ErlendLS/TFE4850/hardware/altium/schematic/a3bu.PNG

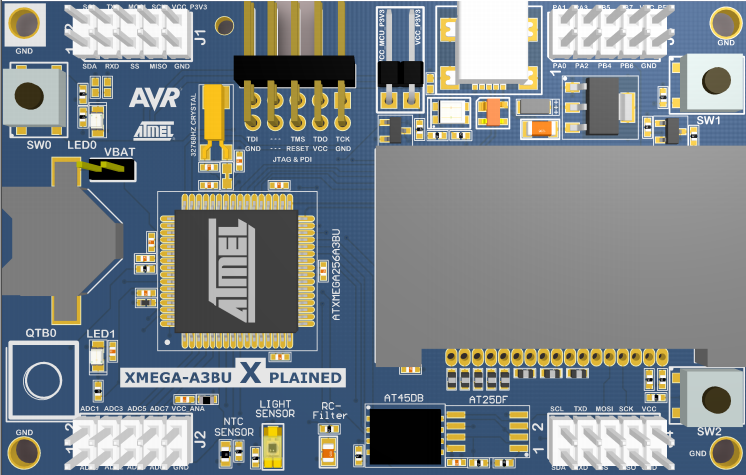
hardware/altium/schematic/a3bu.PNG
