ErlendLS/TFE4850/README.md

TFE4850
=======

Eksperter i Team, Romteknologi, Prosjektrepo
