ErlendLS/TFE4850/hardware/MCU pinout.xlsx

MCU pin | MCU pin mode | Header pin | Xplained pin name | Use on Sensorboard | Use on Xplained
PC0 | TWIC-SDA | J1-1 | SDA | SDA | -
PC1 | TWIC-SCL | J1-2 | SCL | SCL | -
PC2 | GPIO | J1-3 | RXD | OUTPUT_CONTROL1 | -
PC3 | GPIO | J1-4 | TXD | OUTPUT_CONTROL2 | -
PC4 | GPIO | J1-5 | SS | OUTPUT_CONTROL3 | -
PC5 | GPIO | J1-6 | MOSI | OUTPUT_CONTROL4 | -
PC6 |  | J1-7 | MISO | NC | -
PC7 |  | J1-8 | SCK | NC | -
- | - | J1-9 | GND | GND | -
- | - | J1-10 | VCC_P3V3 | NC | -
PB0 | REFB-AREF | J2-1 | ADC0 | VREF_ADC | -
PB1 | ADCB POS-ADC1 | J2-2 | ADC1 | TEMP1 | -
PB2 | ADCB POS-ADC2 | J2-3 | ADC2 | TEMP2 | -
PB3 | ADCB POS-ADC3 | J2-4 | ADC3 | TEMP3 | -
PA4 | ADCB POS-ADC12 | J2-5 | ADC4 | TEMP4 | -
PA5 | ADCB POS-ADC13 | J2-6 | ADC5 | BOARD_GND | -
PA6 |  | J2-7 | ADC6 | NC | -
PA7 |  | J2-8 | ADC7 | NC | -
- | - | J2-9 | GND | GND | -
- | - | J2-10 | VCC_P3V3 | NC | -
PA0 |  | J3-1 | PA0 | NC | Light sensor | cut possible
PA1 |  | J3-2 | PA1 | NC | Temperature sensor | cut possible
PA2 |  | J3-3 | PA2 | NC | Filter output | cut possible
PA3 |  | J3-4 | PA3 | NC | Display reset
PB4 |  | J3-5 | PB4 | NC | JTAG TMS
PB5 |  | J3-6 | PB5 | NC | JTAG TDI
PB6 |  | J3-7 | PB6 | NC | JTAG TCK
PB7 |  | J3-8 | PB7 | NC | JTAG TDO
- | - | J3-9 | GND | GND | -
- | - | J3-10 | VCC_P5V0 | 5V_XPLAINED | -
PE0 |  | J4-1 | SDA | NC | -
PE1 |  | J4-2 | SCL | NC | -
PE2 |  | J4-3 | RXD | NC | -
PE3 |  | J4-4 | TXD | NC | -
PD0 |  | J4-5 | SS | NC | Display register select
PD3 |  | J4-6 | MOSI | NC | Serial flash MOSI
PD2 |  | J4-7 | MISO | NC | Display and flash
PD1 |  | J4-8 | SCK | NC | Display and flash
- | - | J4-9 | GND | NC | -
- | - | J4-10 | VCC_P3V3 | NC | -
