ErlendLS/TFE4850/hardware/altium/Project Outputs for sensorboard/bom_test.xls

Sheet: BOM Report
Bill of Materials |  |  | Bill of Materials For Project [sensorboard.PrjPCB] (No PCB Document Selected)
Source Data From: |  | sensorboard.PrjPCB
Project: |  | sensorboard.PrjPCB
Variant: |  | None
Creation Date: | 21.02.2014 | 00:30:20
Print Date: | 2014-02-21 | 0:30:28
Production Quantity: | 1
Currency | <none>
Footprint | Comment | #Column Name Error:LibRef | Designator | Description | Quantity | Supplier 1 | Supplier Part Number 1 | Supplier Unit Price 1 | Supplier Order Qty 1 | Supplier Subtotal 1 | #Column Name Error:Manufacturer 1 | #Column Name Error:Manufacturer Part Number 1
 | CRCW0805715KFKEA |  | R14_T1, R14_T2, R14_T3, R14_T4 | Thick film resistor, 1%, 125mW | 4 | Mouser | 71-CRCW0805715KFKEA | 0,541 | 4 | $2164.00
 | CRCW0805442RFKEA |  | R7_T1, R7_T2, R7_T3, R7_T4 | Thick film resistor, 1%, 125mW | 4 | Mouser | 71-CRCW0805-442-E3 | 0,541 | 4 | $2164.00
 | CRCW0805300RFKEA |  | R15, R17, R19, R21 | Thick film resistor, 1%, 125mW | 4 | Mouser | 71-CRCW0805300RFKEA | 0,541 | 4 | $2164.00
 | CRCW0805294KFKEA |  | R13_T1, R13_T2, R13_T3, R13_T4 | Thick film resistor, 1%, 125mW | 4 | Mouser | 71-CRCW0805294KFKEA | 0,541 | 4 | $2164.00
 | CRCW0805220RFKEA |  | R27 | Thick film resistor, 1%, 125mW | 1 | Mouser | 71-CRCW0805-220-E3 | 0,541 | 1 | 0,541
 | CRCW0805215KFKEA |  | R12_T1, R12_T2, R12_T3, R12_T4 | Thick film resistor, 1%, 125mW | 4 | Mouser | 71-CRCW0805-215K-E3 | 0,541 | 4 | $2164.00
 | CRCW0805133KFKEA |  | R11_T1, R11_T2, R11_T3, R11_T4 | Thick film resistor, 1%, 125mW | 4 | Mouser | 71-CRCW0805-133K-E3 | 0,541 | 4 | $2164.00
 | C0805C104K5RACTU |  | C1, C2, C3_T1, C3_T2, C3_T3, C3_T4, C4_T1, C4_T2, C4_T3, C4_T4, C15, C16, C19 | Ceramic capacitor, X7R, 10%, 50V | 13 | Mouser | 80-C0805C104K5R | 0,676 | 13 | $8788.00
 | C3216C0G1H104J160AA |  | C23 | Ceramic capacitor, C0G, 5%, 50V | 1 | Mouser | 810-C3216C0G1H104J | 4,66 | 1 | 4,66
 | GRM31C5C1E104JA01L |  | C8_T1, C8_T2, C8_T3, C8_T4, C9_T1, C9_T2, C9_T3, C9_T4 | Ceramic capacitor, C0G, 5%, 25V | 8 | Mouser | 81-GRM31C5C1E104JA01 | 2,15 | 10 | 21,5
 | ERJ-6RSFR10V |  | R26 | Thick film resistor, 1%, 125mW | 1 | Mouser | 667-ERJ-6RSFR10V | 4,19 | 1 | 4,19
 | GRM31C5C1H823GA01L |  | C10_T1, C10_T2, C10_T3, C10_T4 | Ceramic capacitor, C0G, 2%, 50V | 4 | Mouser | 81-GRM31C5C1H823GA1L | 7,71 | 4 | 30,84
 | RG2012P-4022-B-T5 |  | R23 | Thin film resistor, 0.1%, 100mW | 1 | Mouser | 754-RG2012P-4022-BT5 | 1,96 | 1 | 1,96
 | CRCW080522K6FKEA |  | R9_T1, R9_T2, R9_T3, R9_T4 | Thick film resistor, 1%, 125mW | 4 | Mouser | 71-CRCW0805-22.6K-E3 | 0,541 | 4 | $2164.00
 | GRM21B5C1H223JA01L |  | C6_T1, C6_T2, C6_T3, C6_T4 | Ceramic capacitor, C0G, 5%, 50V | 4 | Mouser | 81-GRM215C1H223JA01L | 2,16 | 4 | 8,64
 | CRCW080520R0FKEA |  | R28 | Thick film resistor, 1%, 125mW | 1 | Mouser | 71-CRCW0805-20-E3 | 0,541 | 1 | 0,541
 | GRM2195C1H123JA01D |  | C11_T1, C11_T2, C11_T3, C11_T4 | Ceramic capacitor, C0G, 5%, 50V | 4 | Mouser | 81-GRM2195C1H123JA1D | 2,84 | 4 | 11,36
 | C3216X7R1C106K160AC |  | C12, C13 | Ceramic capacitor, X7R, 10%, 16V | 2 | Mouser | 810-C3216X7R1C106K | 2,30 | 2 | 4,6
 | CRCW080510M0FKEA |  | R5_T1, R5_T2, R5_T3, R5_T4 | Thick film resistor, 1%, 125mW | 4 | Mouser | 71-CRCW0805-10M-E3 | 0,541 | 4 | $2164.00
 | CRCW080510K0FKEB |  | R3, R4, R6_T1, R6_T2, R6_T3, R6_T4, R8_T1, R8_T2, R8_T3, R8_T4, R10_T1, R10_T2, R10_T3, R10_T4, R16, R18, R20, R22 | Thick film resistor, 1%, 125mW | 18 | Mouser | 71-CRCW080510K0FKEB | 0,321 | 18 | $5778.00
 | RG2012P-103-B-T5 |  | R24 | Thin film resistor, 0.1%, 100mW | 1 | Mouser | 754-RG2012P-103-B-T5 | 1,96 | 1 | 1,96
 | C2012X7R1A475K125AC |  | C22 | Ceramic capacitor, X7R, 10%, 10V | 1 | Mouser | 810-C2012X7R1A475K | 1,76 | 1 | 1,76
 | CRCW08054K70FKEB |  | R1, R2 | Thick film resistor, 1%, 125mW | 2 | Mouser | 71-CRCW08054K70FKEB | 0,541 | 2 | $1082.00
 | C0805C105K4RACTU |  | C14, C17, C18, C20, C21_T1, C21_T2, C21_T3, C21_T4 | Ceramic capacitor, X7R, 10%, 16V | 8 | Mouser | 80-C0805C105K4R | 0,811 | 8 | $6488.00
 | GRM2165C1H102JA01D |  | C5_T1, C5_T2, C5_T3, C5_T4, C7_T1, C7_T2, C7_T3, C7_T4 | Ceramic capacitor, C0G, 5%, 50V | 8 | Mouser | 81-GRM40C102J50D | 0,389 | 10 | 3,89
 | CRCW08050000Z0EA |  | R25_T1, R25_T2, R25_T3, R25_T4 | Thick film resistor, 1%, 125mW | 4 | Mouser | 71-CRCW0805-0-E3 | 0,541 | 4 | $2164.00
 | 1751248 |  | J4, J5, J6, J7, J9 | Terminal block, 2P, 3.5mm, screw | 5 | Mouser | 651-1751248 | 7,50 | 5 | 37,5
 | 1751303 |  | J8 | Terminal block, 8P, 3.5mm, screw | 1 | Mouser | 651-1751303 | 28,90 | 1 | 28,9
 | AD623BRZ |  | U4_T1, U4_T2, U4_T3, U4_T4 | Instrumentation amplifier, rail to rail | 4 | Mouser | 584-AD623BRZ | 42,33 | 4 | 169,32
 | ADR3425ARJZ |  | U13 | Series voltage reference, 2.5V | 1 | Mouser | 584-ADR3425ARJZ-R7 | 17,49 | 1 | 17,49
 | ADT7410TRZ |  | U2 | Temperature sensor, I2C output | 1 | Mouser | 584-ADT7410TRZ | 23,83 | 1 | 23,83
 | AQV252GA |  | U5, U6, U7, U8 | Solid state relay, DC/AC, 60V, 2.5A | 4 | Mouser | 769-AQV252GA | 34,98 | 4 | 139,92
 | HSCDANN015PA2A3 |  | U1 | Absolute pressure sensor, I2C output | 1 | Mouser | 785-HSCDANN015PA2A3 | 298,37 | 1 | 298,37
 | KP-3216CGCK |  | D1 | Chip led lamp,green, 50mcd @ 20mA | 1 | Farnell | 2290333 | 0,94 | 1
 | LMP7702MA/NOPB |  | U3_T1, U3_T2, U3_T3, U3_T4, U10 | Op. amp, dual, rail-to-rail, single supply | 5 | Farnell | 1651867 | 18,17 | 5
 | SA36CA-E3/54 |  | TVS1, TVS2, TVS3, TVS4 | TVS diode, bidirectional, 36 V | 4 | Mouser | 625-SA36CA-E3/54 | 3,45 | 4 | 13,8
 | T821110A1S100CEU |  | J1, J2, J3 | Header, 2x5, 2.54mm | 3 | Farnell | 2215304 | 4,03 | 3
 | Test_point |  | TP1, TP2, TP3_T1, TP3_T2, TP3_T3, TP3_T4, TP4_T1, TP4_T2, TP4_T3, TP4_T4, TP5, TP6, TP7, TP8, TP9 | Test_point | 15
 | TPS7A4533DCQ |  | U9 | LDO regulator, 3.3V, 1.5A | 1 | Mouser | 595-TPS7A4533DCQT | 25,35 | 1 | 25,35
 |  |  |  |  | 160 |  |  |  |  | $41612.00
Approved |  | Notes

Sheet: Project Information
Project Full Path | C:\Users\Harald\Documents\Dropbox\Studier\Semester 08\TFE4850 - EIT romteknologi\TFE4850\hardware\altium\sensorboard.PrjPCB
Project Filename | sensorboard.PrjPCB
Variant Name | None
Data-Source Filename | sensorboard.PrjPCB
Data-Source Full Path | C:\Users\Harald\Documents\Dropbox\Studier\Semester 08\TFE4850 - EIT romteknologi\TFE4850\hardware\altium\sensorboard.PrjPCB
Title | Bill of Materials For Project [sensorboard.PrjPCB] (No PCB Document Selected)
Total Quantity | 160
Report Time | 00:30:20
Report Date | 21.02.2014
Report Date & Tine | 21.02.2014 00:30:20
Output Name | Bill of Materials
Output Type | BOM_PartType
Output Generator Name | BOM
Output Generator Description | Bill of Materials
