ErlendLS/TFE4850/hardware/altium/sensorboard.PDF

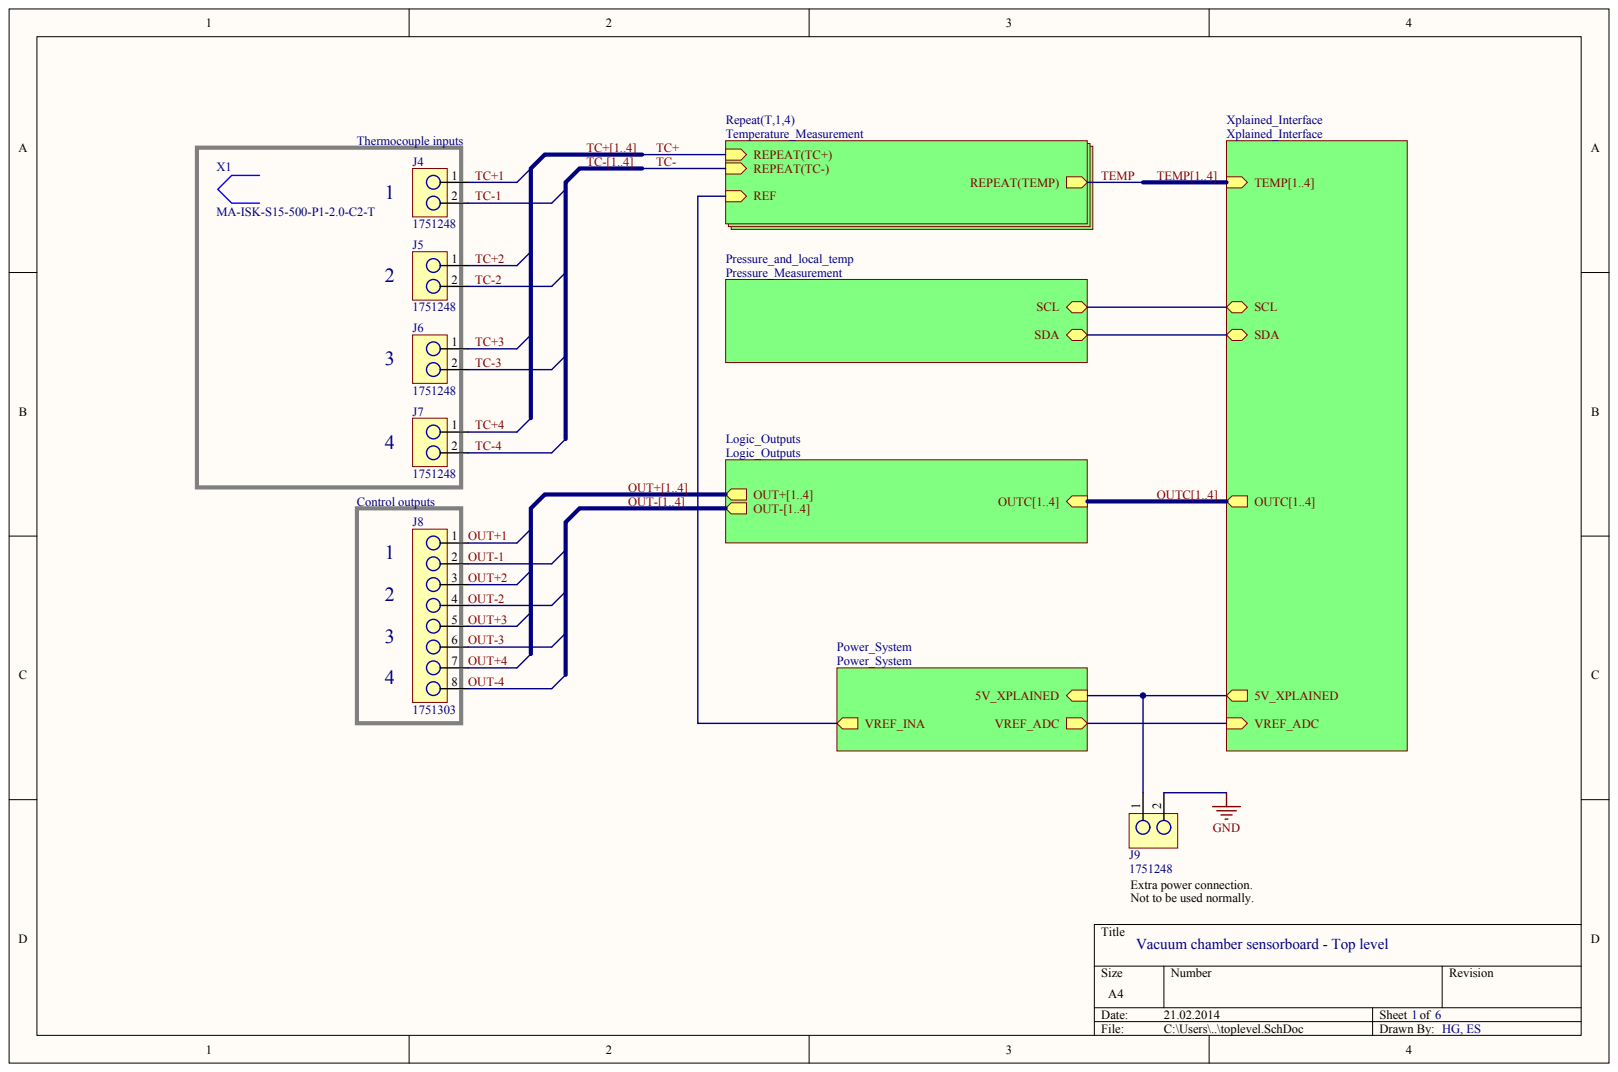
[picture p2: page 1]

Extra power connection.
Not to be used normally

Title
Vacuum chamber sensorboard - Top level

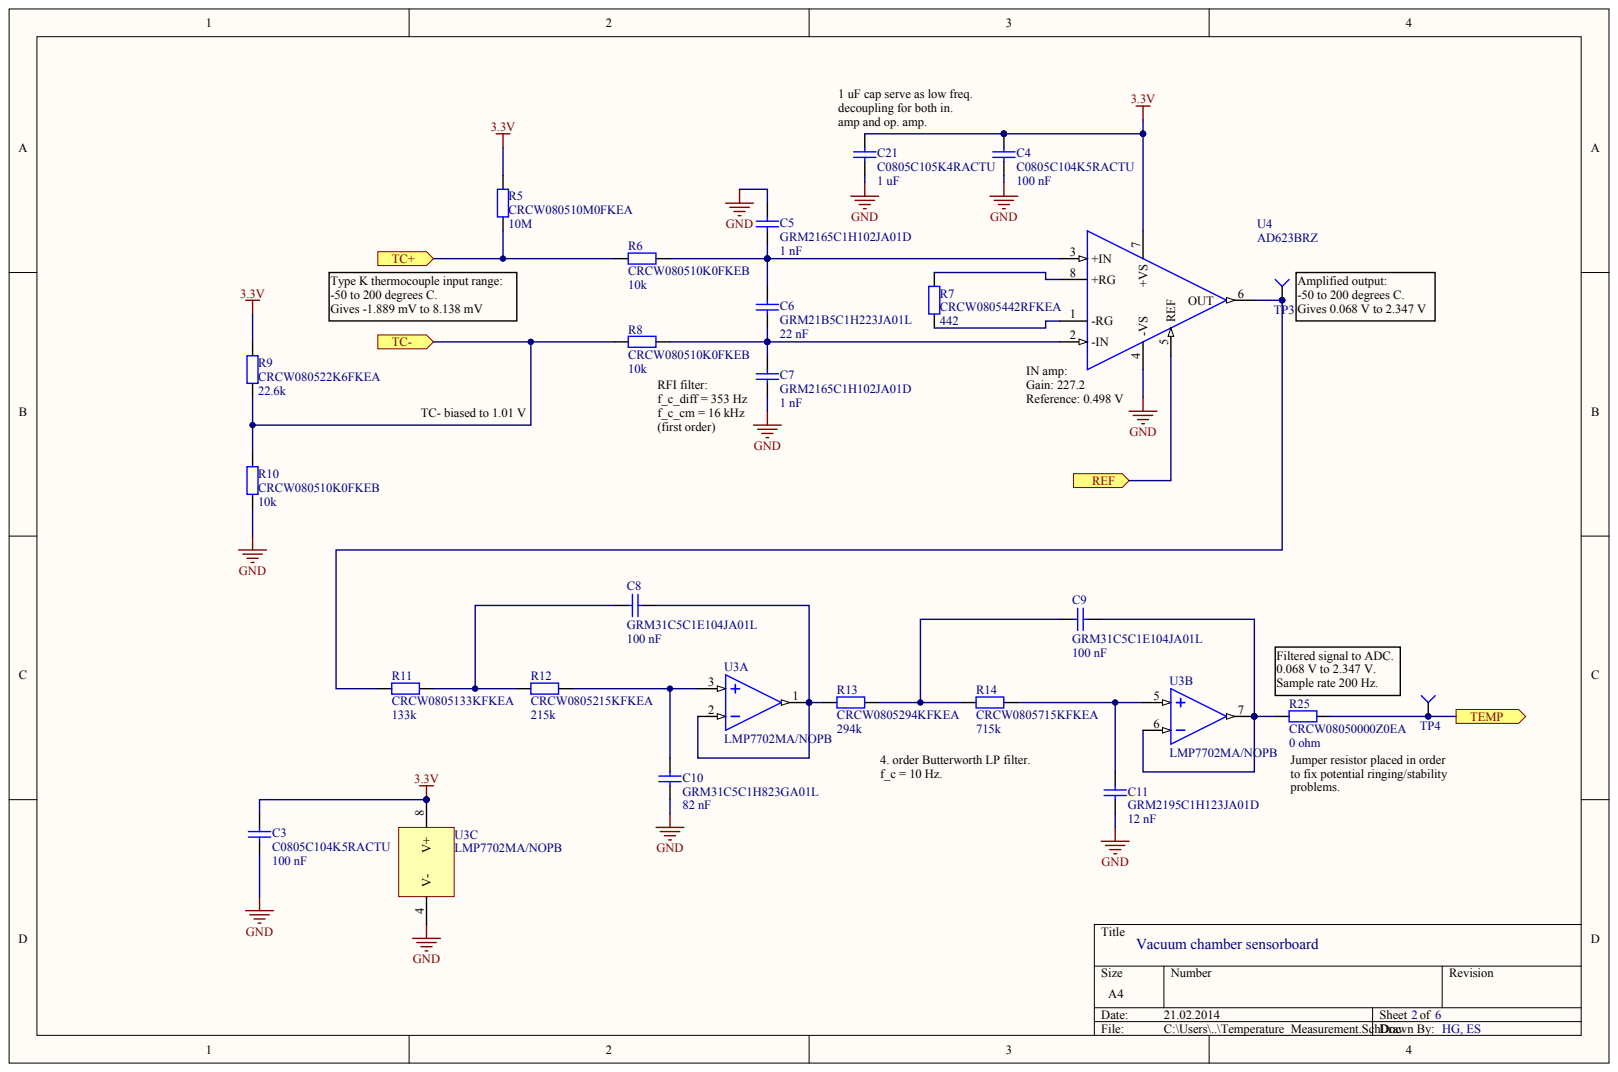
[picture p3: page 2]

1 uF cap serve as low freq.
decoupling for both in.
amp and op. amp.

Type K thermocouple input range:
-50 to 200 degrees C.
Gives -1.889 mV to 8.138 mV

Filtered signal to ADC.
Sample rate 200 Hz.

CRCW08050000Z0EA
0 ohm
Jumper resistor placed in order
to fix potential ringing/stability
problems.

4. order Butterworth LP filter.

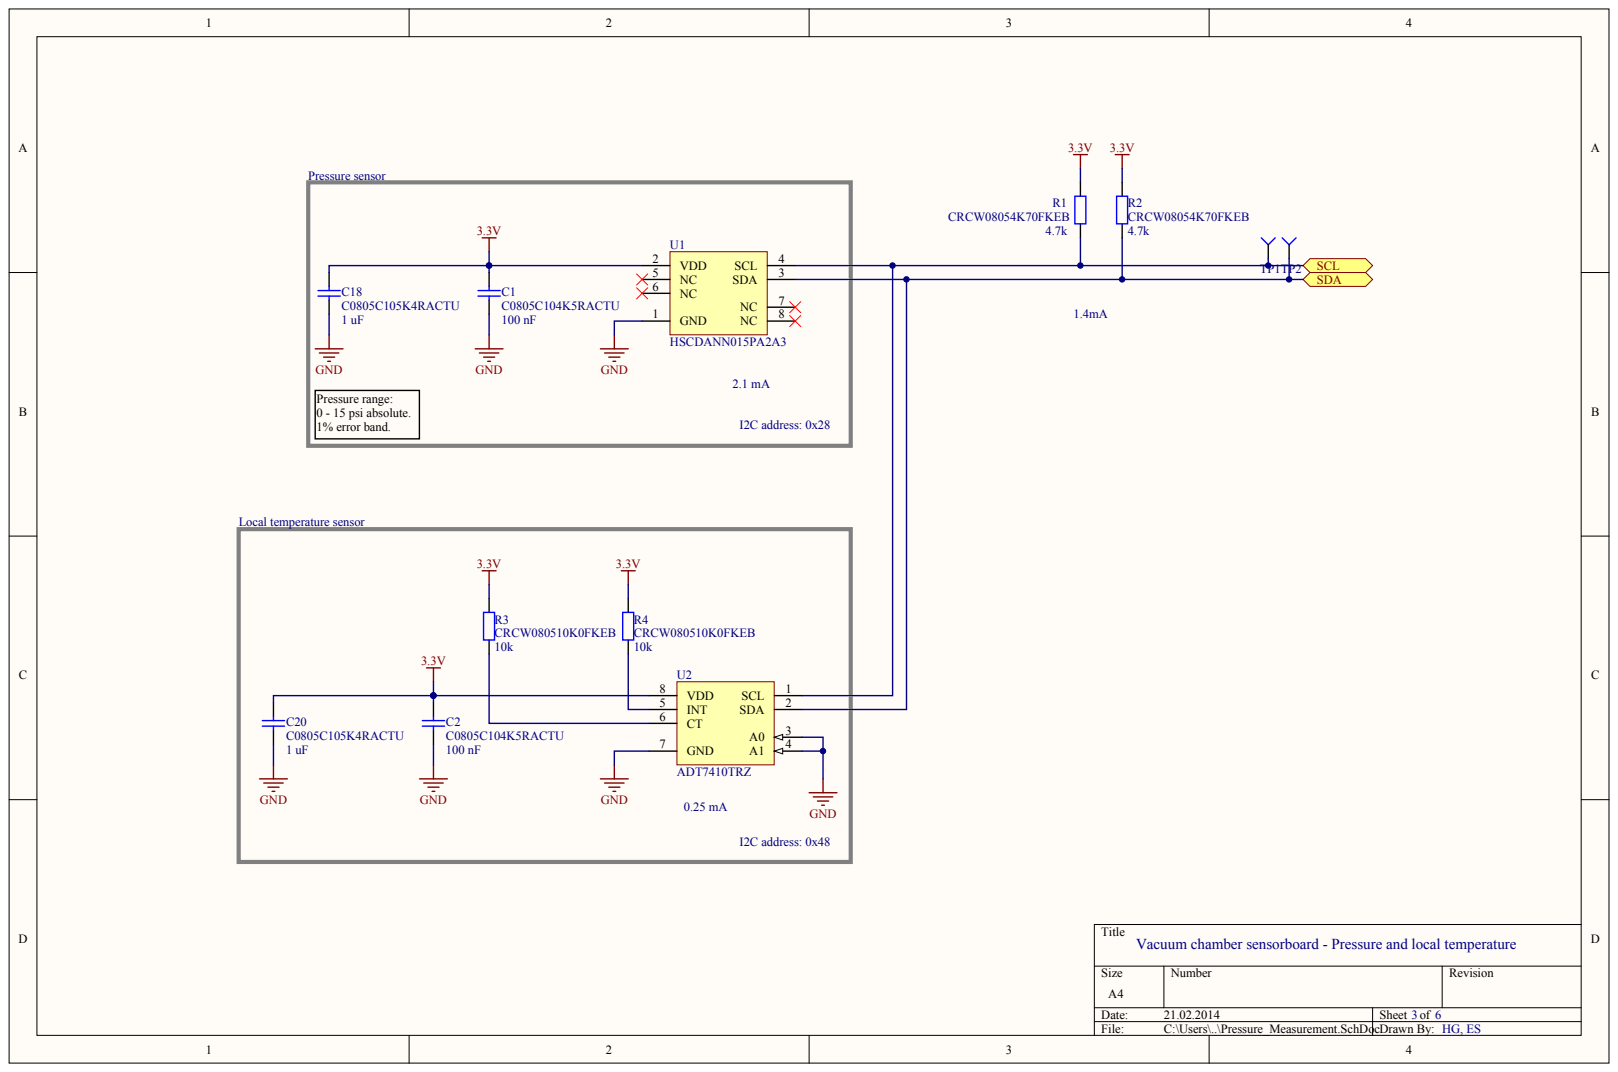
[picture p4: page 3]

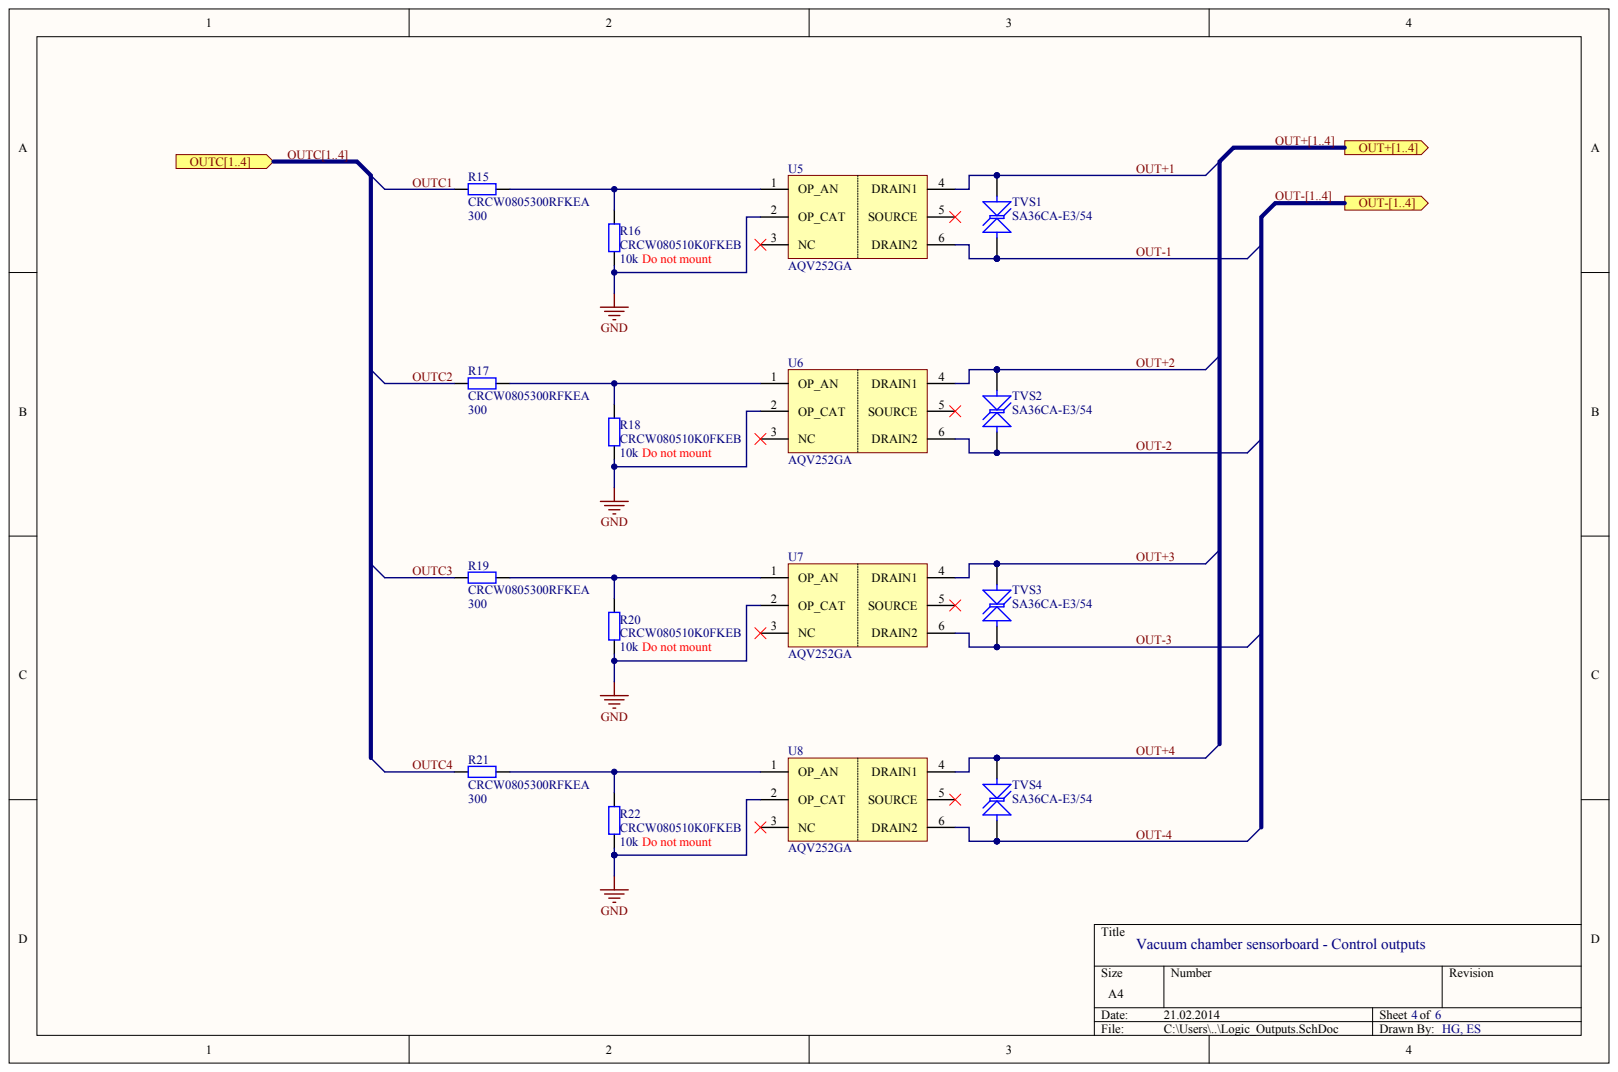
[picture p5: page 4]

OP_AN OP_CAT NC | DRAIN1 SOURCE DRAIN2

10k Do not mount | 3

OUT-2

OUT-3

Title
Vacuum chamber sensorboard - Control outputs 4

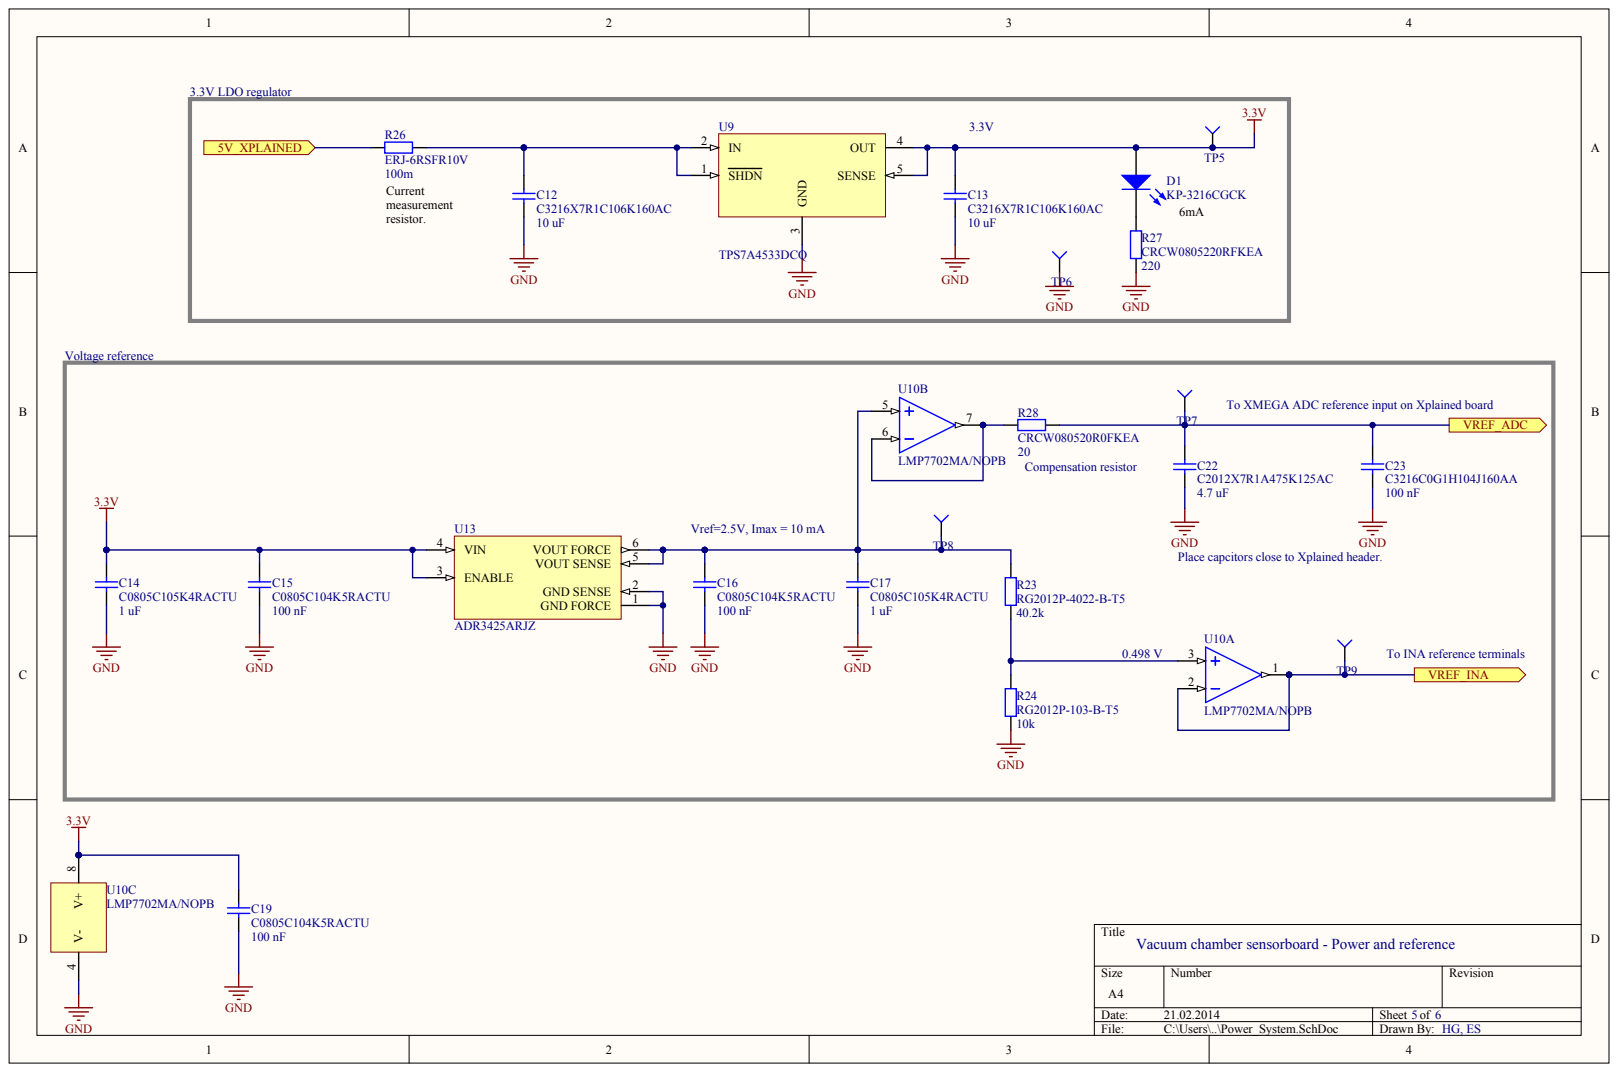
[picture p6: page 5]

To XMEGA ADC reference input on Xplained board

Place capcitors close to Xplained header.

To INA reference terminals

Title
Vacuum chamber sensorboard - Power and reference

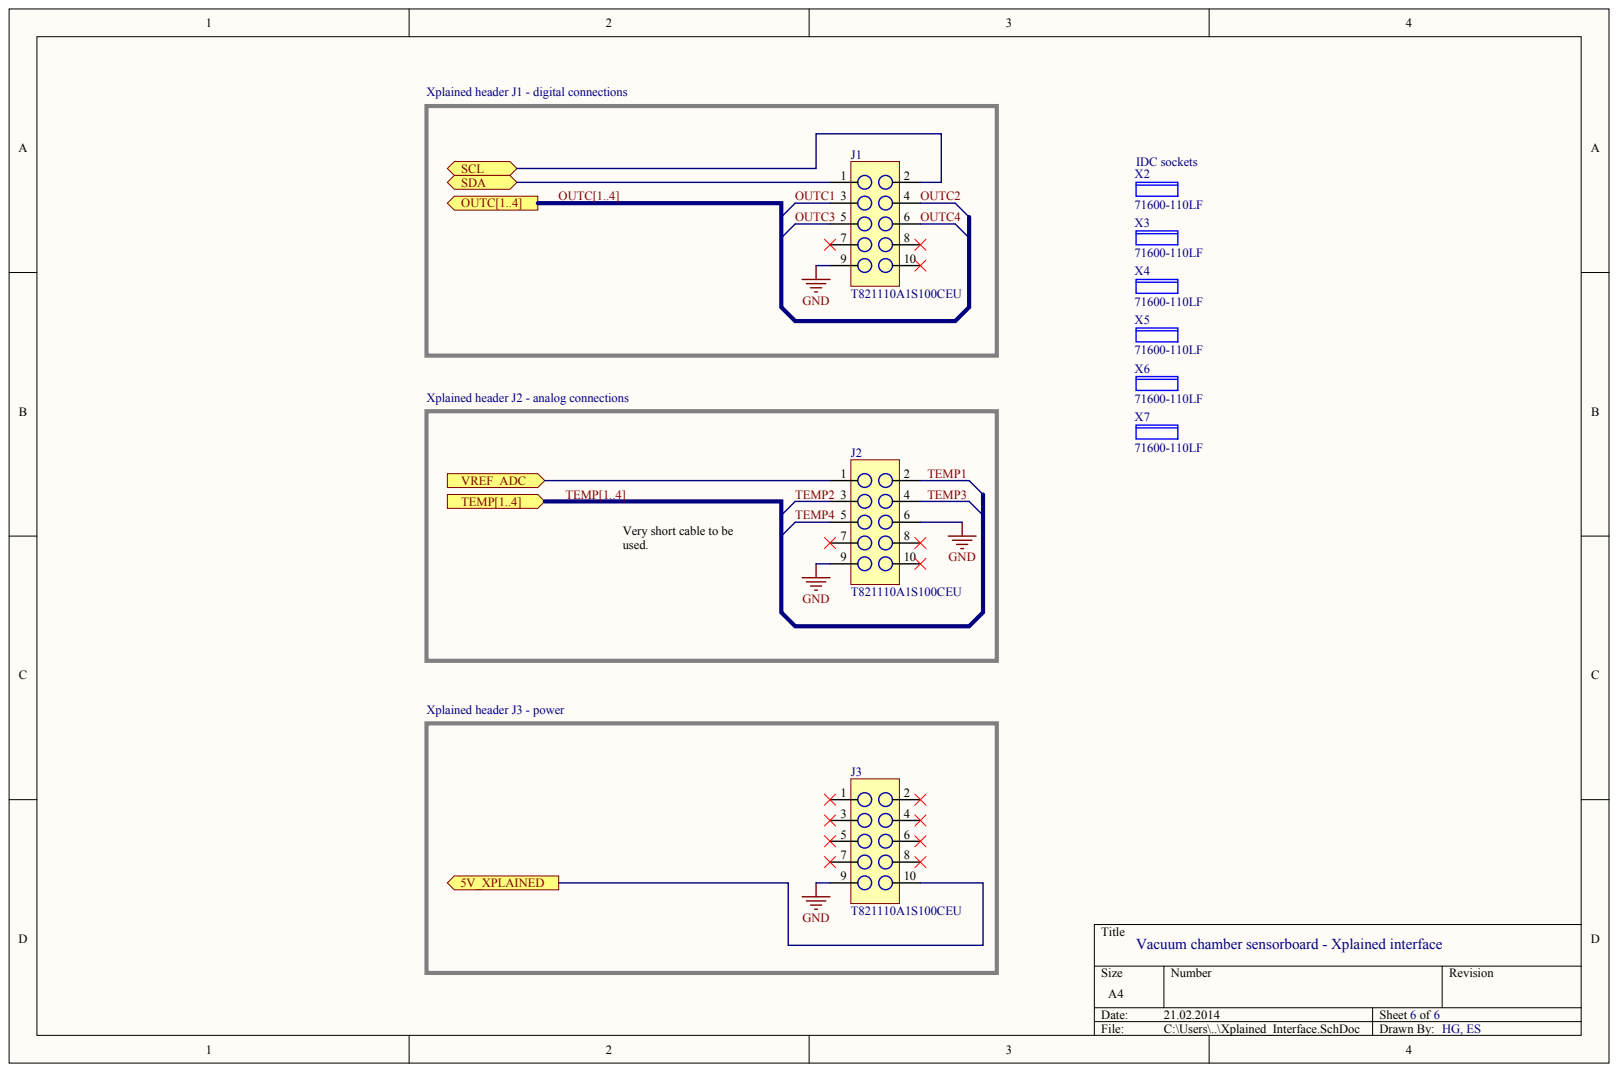
[picture p7: page 6]

Xplained header J1 - digital connections

Xplained header J2 - analog connections

Very short cable to be
used.

Title
Vacuum chamber sensorboard - Xplained interface
