ErlendLS/TFE4850/hardware/altium/Project Outputs for sensorboard/bom_test.pdf

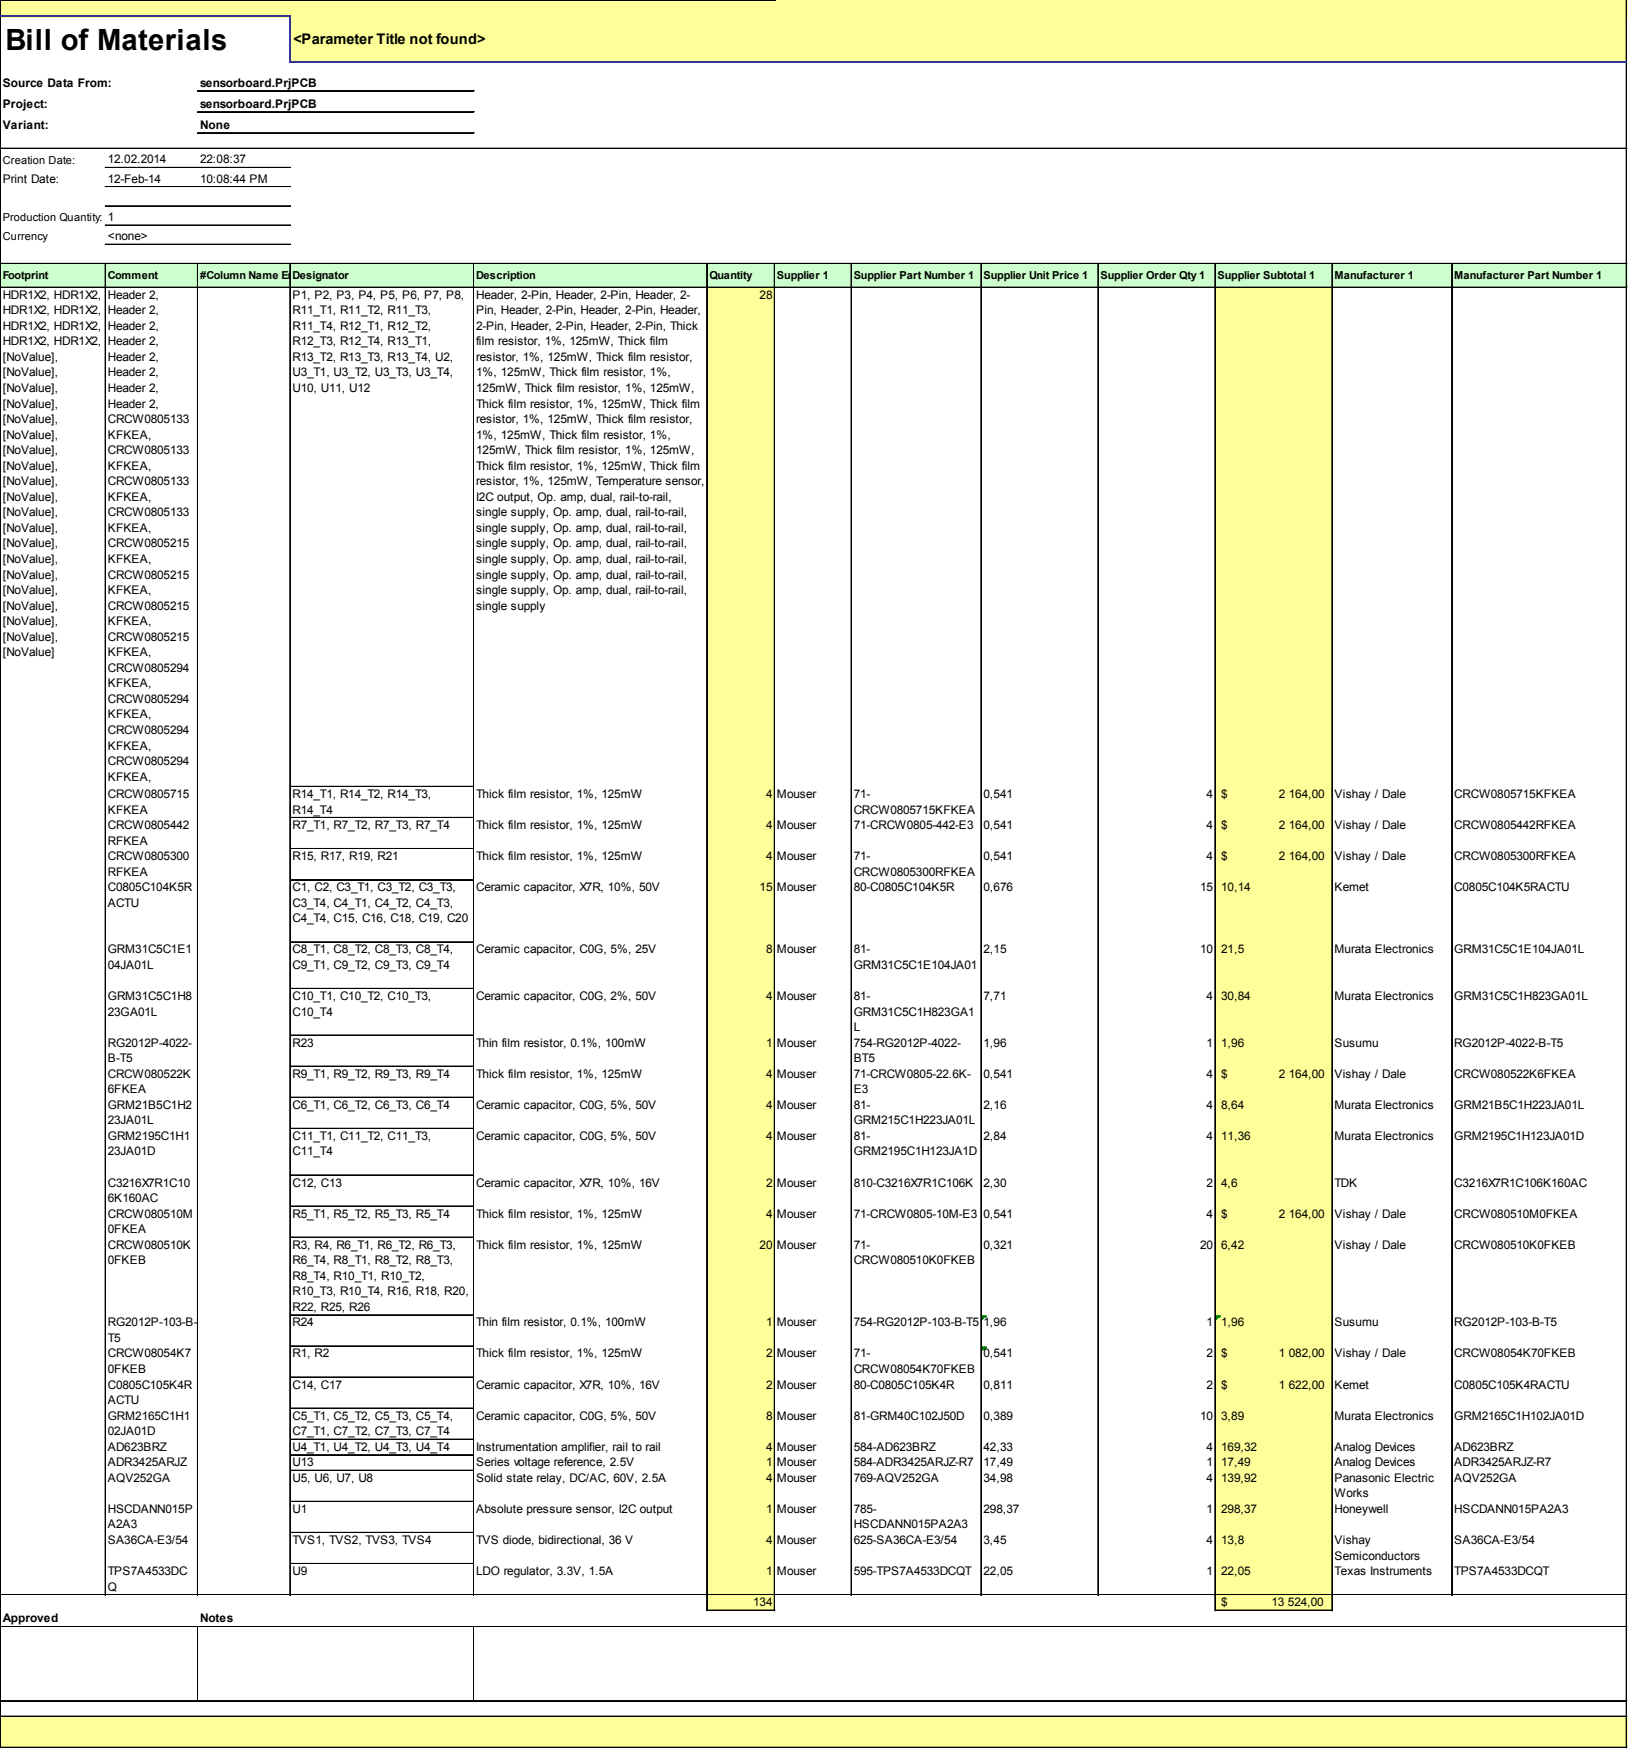
[picture p8: page 1]

Footprint | Comment | #Column Name ErDesignator | | Description | Quantity | Supplier 1 | Supplier Part Number 1 | Supplier Unit Price 1 | Supplier Order Qty 1 | Supplier Subtotal 1 | Manufacturer 1 | Manufacturer Part Number 1

Header, 2-Pin, Header, 2-Pin, Header, 2-
Pin, Header, 2-Pin, Header, 2-Pin, Header,
2-Pin, Header, 2-Pin, Header, 2-Pin, Thick
film resistor, 1%, 125mW, Thick film
resistor, 1%, 125mW, Thick film resistor,
1%, 125mW, Thick film resistor, 1%,
125mW, Thick film resistor, 1%, 125mW,
Thick film resistor, 1%, 125mW, Thick film
resistor, 1%, 125mW, Temperature sensor,
I2C output, Op. amp, dual, rail-to-rail,
single supply, Op. amp, dual, rail-to-rail,
single supply
