ErlendLS/TFE4850/(list of files, drawings)

Other design files:
hardware/altium/schematic/Logic_Outputs.SchDoc
hardware/altium/schematic/Power_System.SchDoc
hardware/altium/schematic/Pressure_Measurement.SchDoc
hardware/altium/schematic/Temperature_Measurement.SchDoc
hardware/altium/schematic/toplevel.SchDoc
hardware/altium/schematic/Xplained_Interface.SchDoc
hardware/altium/Sensorboard.PcbDoc
hardware/altium/sensorboard.PrjPCB
