ErlendLS/TFE4850/(commit log)

2014-01-22 Lagt inn dokumentasjon av mikrokontroller
    [XMEGA-A3BU_XPLAINED_pcb_rev2.DRL, XMEGA-A3BU_XPLAINED_pcb_rev2.GBL, XMEGA-A3BU_XPLAINED_pcb_rev2.GBO, XMEGA-A3BU_XPLAINED_pcb_rev2.GBP, XMEGA-A3BU_XPLAINED_pcb_rev2.GBS, XMEGA-A3BU_XPLAINED_pcb_rev2.GM1, XMEGA-A3BU_XPLAINED_pcb_rev2.GTL, XMEGA-A3BU_XPLAINED_pcb_rev2.GTO]
2014-02-03 Opprettet Altium-prosjekt, samt startet på top level skjema.
    [Temperature_Measurement.SchDoc, sensorboard.PrjPCB, toplevel.SchDoc]
2014-02-03 ...og de siste filene
    [sensorboard.PrjPCB]
2014-02-05 Masse greier etter onsdag 05.02
    [Pressure_Measurement.SchDoc, Temperature_Measurement.SchDoc]
2014-02-10 Etter tirsdag 10. feb (anti aliasing osv)
    [Logic_Outputs.SchDoc, Pressure_Measurement.SchDoc, Temperature_Measurement.SchDoc, sensorboard.PrjPCB, toplevel.CSV, toplevel.SchDoc]
2014-02-26 masse nytt
    [Logic_Outputs.SchDoc, MCU pinout.xlsx, Power_System.SchDoc, Pressure_Measurement.SchDoc, Sensorboard.PcbDoc, Temperature_Measurement.SchDoc, Xplained_Interface.SchDoc, bom_test.xls]
2014-03-04 ferdig utlegg
    [Power_System.SchDoc, Pressure_Measurement.SchDoc, Sensorboard.PcbDoc, Temperature_Measurement.SchDoc, Xplained_Interface.SchDoc, sensorboard.PrjPCB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]
